krups/KREPE3-Hardware/README.md

# KREPE3-Hardware
PCB design files and documentation for the hardware used in the University of Kentucky's 2026 KRUPS ISS mission. Further information for each component is found in its respective folder.

### Hardware Folders
- [Low Power Data Logger](LPDataLogger)
