krups/KREPE3-Hardware/LPDataLogger/Documentation/LPDataLogger.step

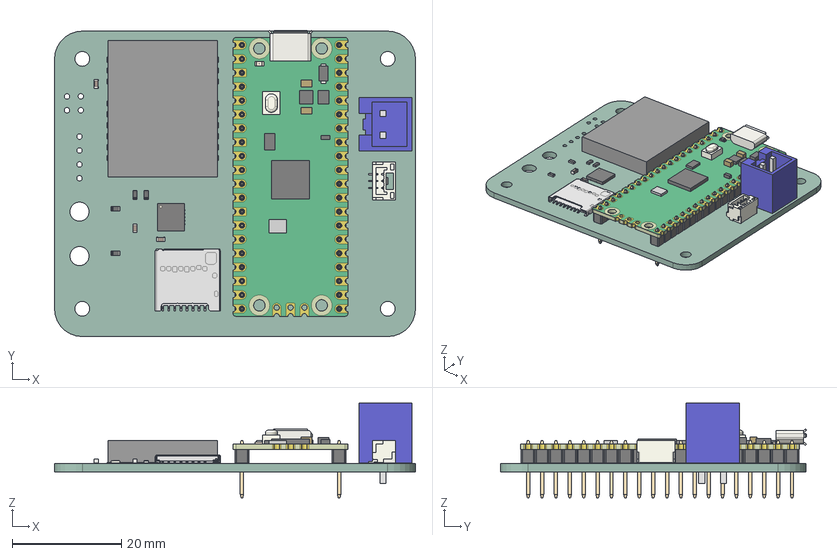
[picture p3: CAD file, 2025-04-11]
LPDataLogger/Documentation/LPDataLogger.step
66.0 x 56.0 x 17.4 mm
B2P-VH-FB-B
Pins
C_0603_1608Metric x 3
R_0603_1608Metric x 4
RaspberryPi_Pico_AddedHeaders
JST_GH_BM03B-GHS-TBT_1x03-1MP_P1.25mm_Vertical
QFN-20-1EP_5x5mm_P0.65mm_EP3.35x3.35mm
LPDataLogger_PCB
