krups/KREPE3-Hardware/LPDataLogger/KiCadProjectFiles/STEP/FSM300.stp

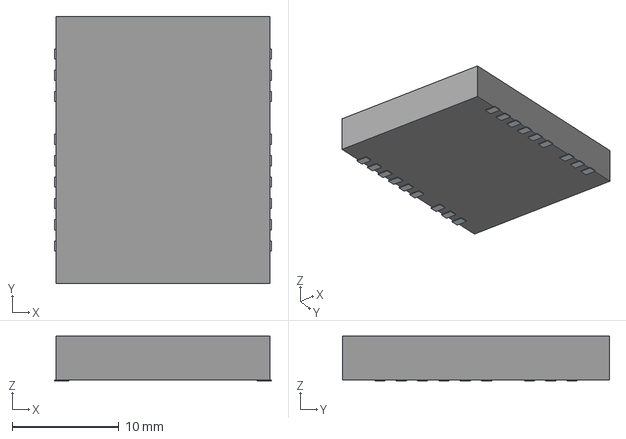
[picture p4: CAD file, 2025-04-10]
LPDataLogger/KiCadProjectFiles/STEP/FSM300.stp
20.4 x 25.0 x 4.20 mm
Pins
