krups/KREPE3-Hardware/LPDataLogger/KiCadProjectFiles/STEP/B2P-VH-FB-B.STEP

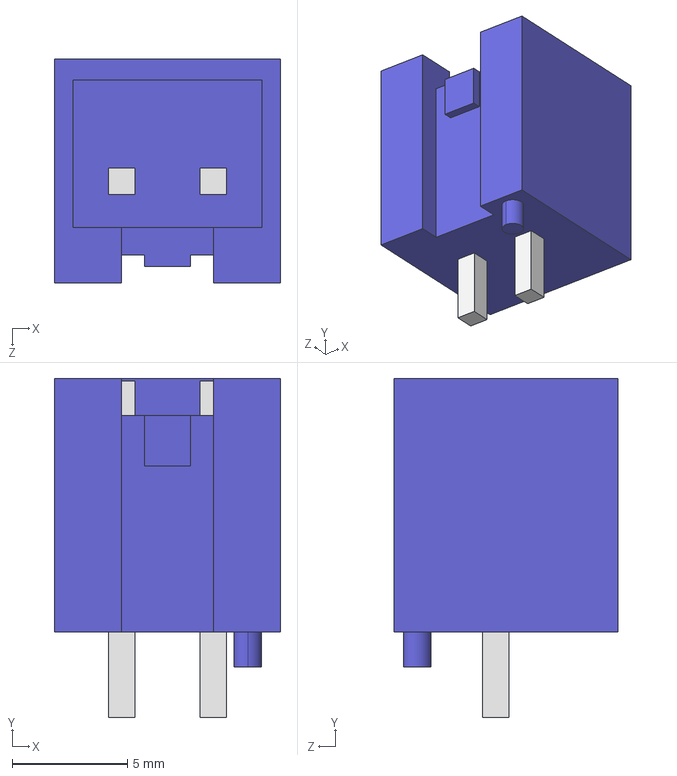
[picture p5: CAD file, 2025-04-10]
LPDataLogger/KiCadProjectFiles/STEP/B2P-VH-FB-B.STEP
9.80 x 14.7 x 9.70 mm
