krups/KREPE3-Hardware/LPDataLogger/KiCadProjectFiles/STEP/RaspberryPi_Pico_AddedHeaders.step

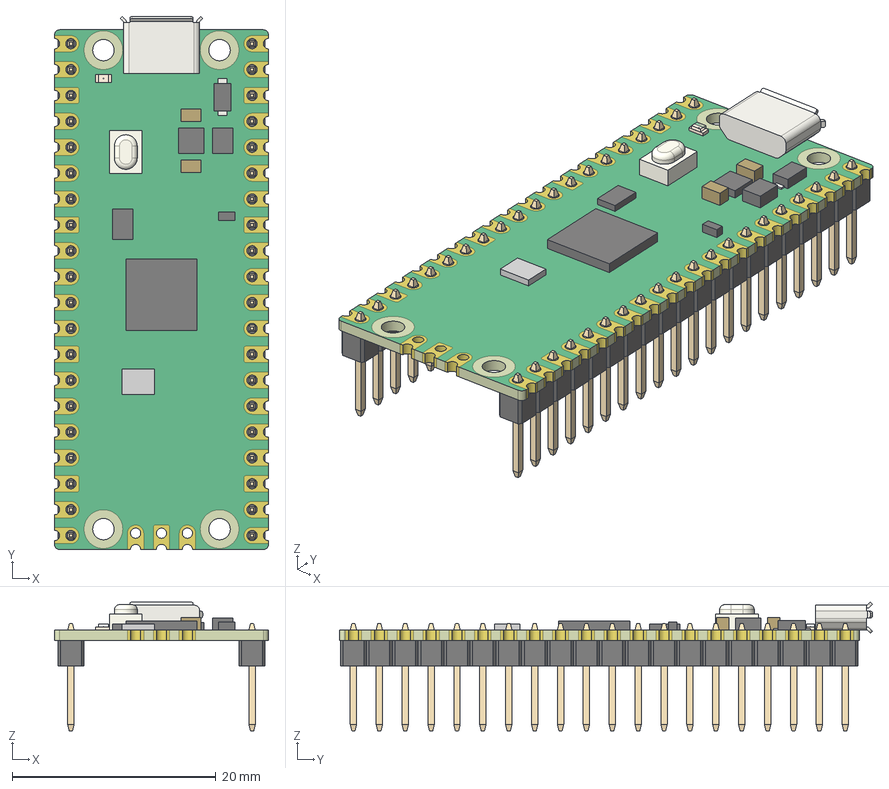
[picture p6: CAD file, 2025-04-10]
LPDataLogger/KiCadProjectFiles/STEP/RaspberryPi_Pico_AddedHeaders.step
21.0 x 52.3 x 12.6 mm
