krups/KREPE3-Hardware/LPDataLogger/KiCadProjectFiles/STEP/1040310811.stp

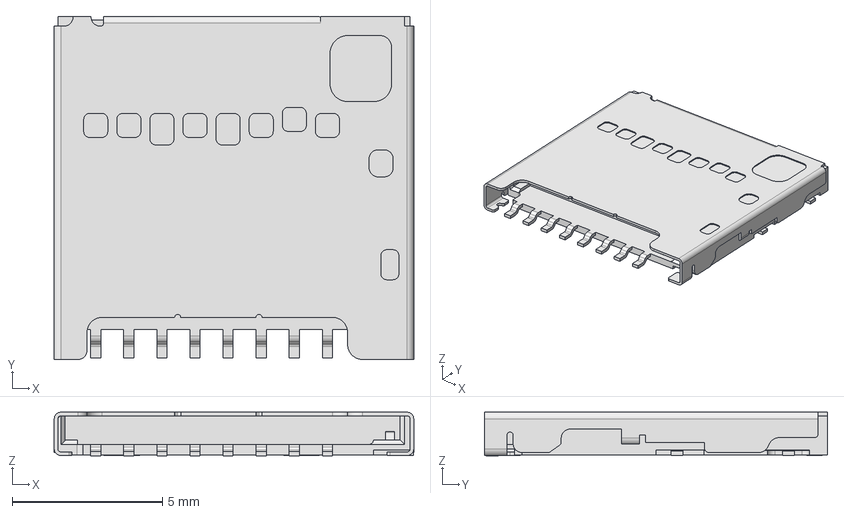
[picture p7: CAD file, 2025-04-10]
LPDataLogger/KiCadProjectFiles/STEP/1040310811.stp
11.9 x 11.4 x 1.45 mm
