krups/KREPE3-Hardware/LPDataLogger/Documentation/LPDataLogger.pdf

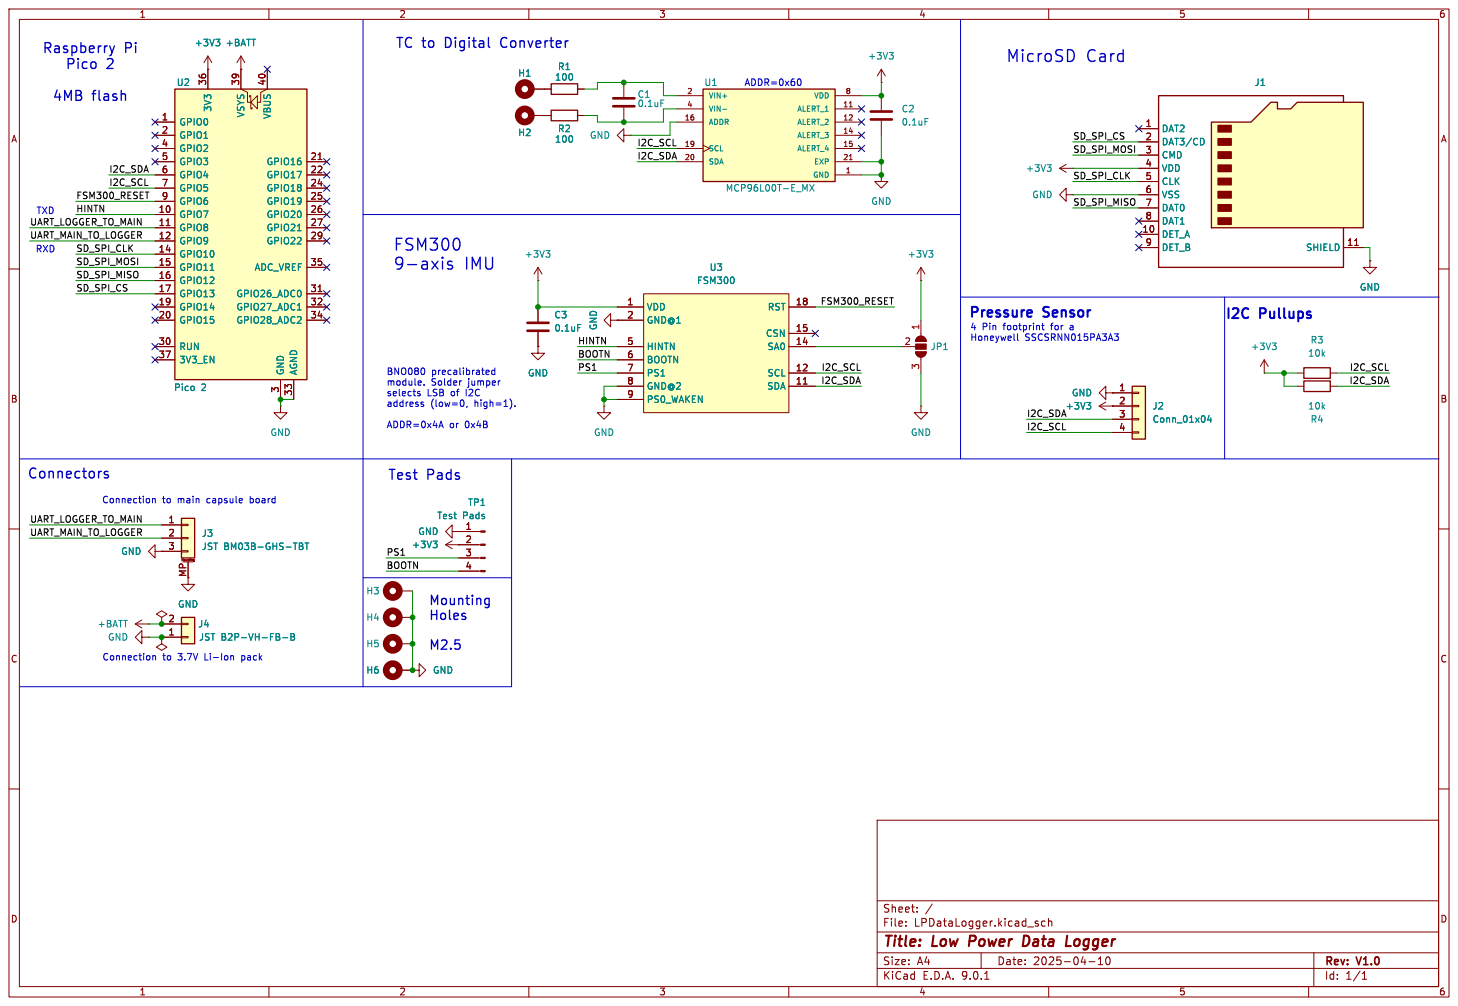
[picture p8: page 1]

TC to Digital Converter

BNO080 precalibrated module. Solder jumper selects LSB of I2C

Id: 1/1 Title: Low Power Data Logger File: LPDataLogger.kicad_sch Sheet: /
