krups/KREPE3-Hardware/LPDataLogger/KiCadProjectFiles/LPDataLogger.kicad_pcb

## KiCad design LPDataLogger/KiCadProjectFiles/LPDataLogger.kicad_pcb (2025-04-11)

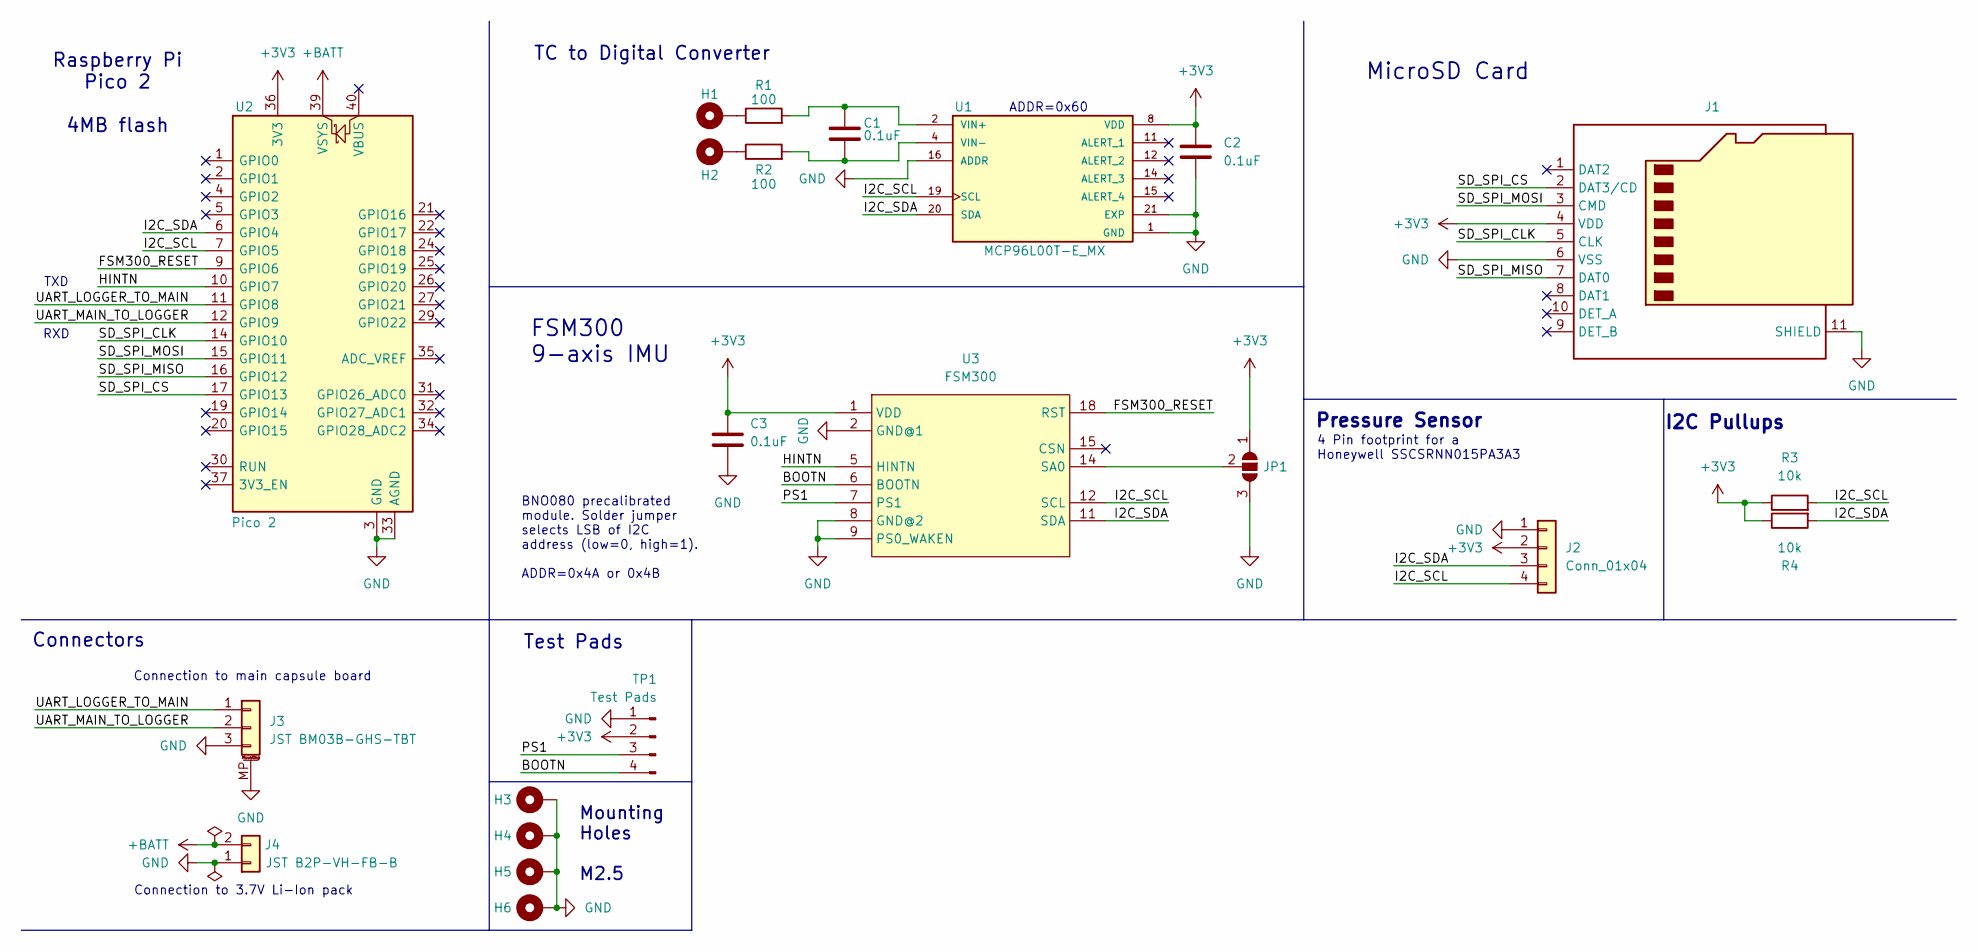
[picture p9: schematic LPDataLogger.kicad_sch, Low Power Data Logger]

Parts:
C1, C2, C3: 0.1uF; C_0603_1608Metric_Pad1.08x0.95mm_HandSolder; Digikey Part Number 0603B104K500XD
H1, H2: MountingHole_Pad; MountingHole_3.5mm_Pad
H3, H4, H5, H6: MountingHole_Pad; MountingHole_2.7mm_M2.5_Pad_with_stencil_hole
J1: Micro_SD_Card_Det2; microSD_HC_Molex_104031-0811; Digikey Part Number WM6357TR-ND
J2: Conn_01x04; PinHeader_1x04_P2.54mm_Vertical
J3: JST BM03B-GHS-TBT; JST_GH_BM03B-GHS-TBT_1x03-1MP_P1.25mm_Vertical; Digikey Part Number 455-BM03B-GHS-TBTCT-ND
J4: JST B2P-VH-FB-B; JST_VH_B2P-VH-FB-B_1x02_P3.96mm_Vertical; Digikey Part Number 455-B2P-VH-FB-B-ND
JP1: SolderJumper_3_Open; SolderJumper-3_P1.3mm_Open_RoundedPad1.0x1.5mm_NumberLabels
R1, R2: 100; R_0603_1608Metric_Pad0.98x0.95mm_HandSolder; Digikey Part Number 311-100GRTR-ND
R3, R4: 10k; R_0603_1608Metric_Pad0.98x0.95mm_HandSolder; Digikey Part Number 13-RC0603FR-1310KLTR-ND
TP1: Test Pads; PinHeader_2x02_P2.54mm_Vertical
U1: MCP96L00T-E_MX; QFN-20-1EP_5x5mm_P0.65mm_EP3.35x3.35mm; Digikey Part Number MCP96L00T-E/MXTR-ND
U2: Pico 2; RaspberryPi_Pico_Common_Unspecified; Digikey Part Number 2648-SC1631CT-ND
U3: FSM300; Digikey Part Number 1888-1001-ND

Connections:
+3V3: C2.1, C3.1, J1.4 (VDD), J2.2, JP1.1 (A), R3.1, R4.1, TP1.2, U1.8 (VDD), U2.36 (3V3), U3.1 (VDD)
+BATT: J4.2, U2.39 (VSYS)
/BOOTN: TP1.4, U3.6 (BOOTN)
/FSM300_RESET: U2.9 (GPIO6), U3.18 (RST)
/HINTN: U2.10 (GPIO7), U3.5 (HINTN)
/I2C_SCL: J2.4, R3.2, U1.19 (SCL), U2.7 (GPIO5), U3.12 (SCL)
/I2C_SDA: J2.3, R4.2, U1.20 (SDA), U2.6 (GPIO4), U3.11 (SDA)
/PS1: TP1.3, U3.7 (PS1)
/SD_SPI_CLK: J1.5 (CLK), U2.14 (GPIO10)
/SD_SPI_CS: J1.2 (DAT3/CD), U2.17 (GPIO13)
/SD_SPI_MISO: J1.7 (DAT0), U2.16 (GPIO12)
/SD_SPI_MOSI: J1.3 (CMD), U2.15 (GPIO11)
/UART_LOGGER_TO_MAIN: J3.1, U2.11 (GPIO8)
/UART_MAIN_TO_LOGGER: J3.2, U2.12 (GPIO9)
GND: C2.2, C3.2, H3.1, H4.1, H5.1, H6.1, J1.6 (VSS), J1.11 (SHIELD), J2.1, J3.3, J3.MP (MountPin), J4.1, JP1.3 (B), TP1.1, U1.1 (GND), U1.3 (GND__1), U1.5 (GND__2), U1.6 (GND__3), U1.7 (GND__4), U1.9 (GND__5), U1.10 (GND__6), U1.13 (GND__7), U1.16 (ADDR), U1.17 (GND__8), U1.18 (GND__9), U1.21 (EXP), U2.3 (GND), U2.8 (GND), U2.13 (GND), U2.18 (GND), U2.23 (GND), U2.28 (GND), U2.33 (AGND), U2.38 (GND), U3.2 (GND@1), U3.8 (GND@2), U3.9 (PS0_WAKEN)
unnamed: H1.1, R1.1
unnamed: H2.1, R2.1
unnamed: JP1.2 (C), U3.14 (SA0)
unnamed: C1.1, R1.2, U1.2 (VIN+)
unnamed: C1.2, R2.2, U1.4 (VIN-)

Notes on the sheet:
Connection to main capsule board
MicroSD Card
Mounting Holes M2.5
Connection to 3.7V Li-Ion pack
Test Pads
TC to Digital Converter
I2C Pullups
RXD
FSM300 9-axis IMU
TXD
Pressure Sensor
Connectors
ADDR=0x60
4 Pin footprint for a Honeywell SSCSRNN015PA3A3
BNO080 precalibrated module. Solder jumper selects LSB of I2C address (low=0, high=1). ADDR=0x4A or 0x4B
Raspberry Pi Pico 2 4MB flash

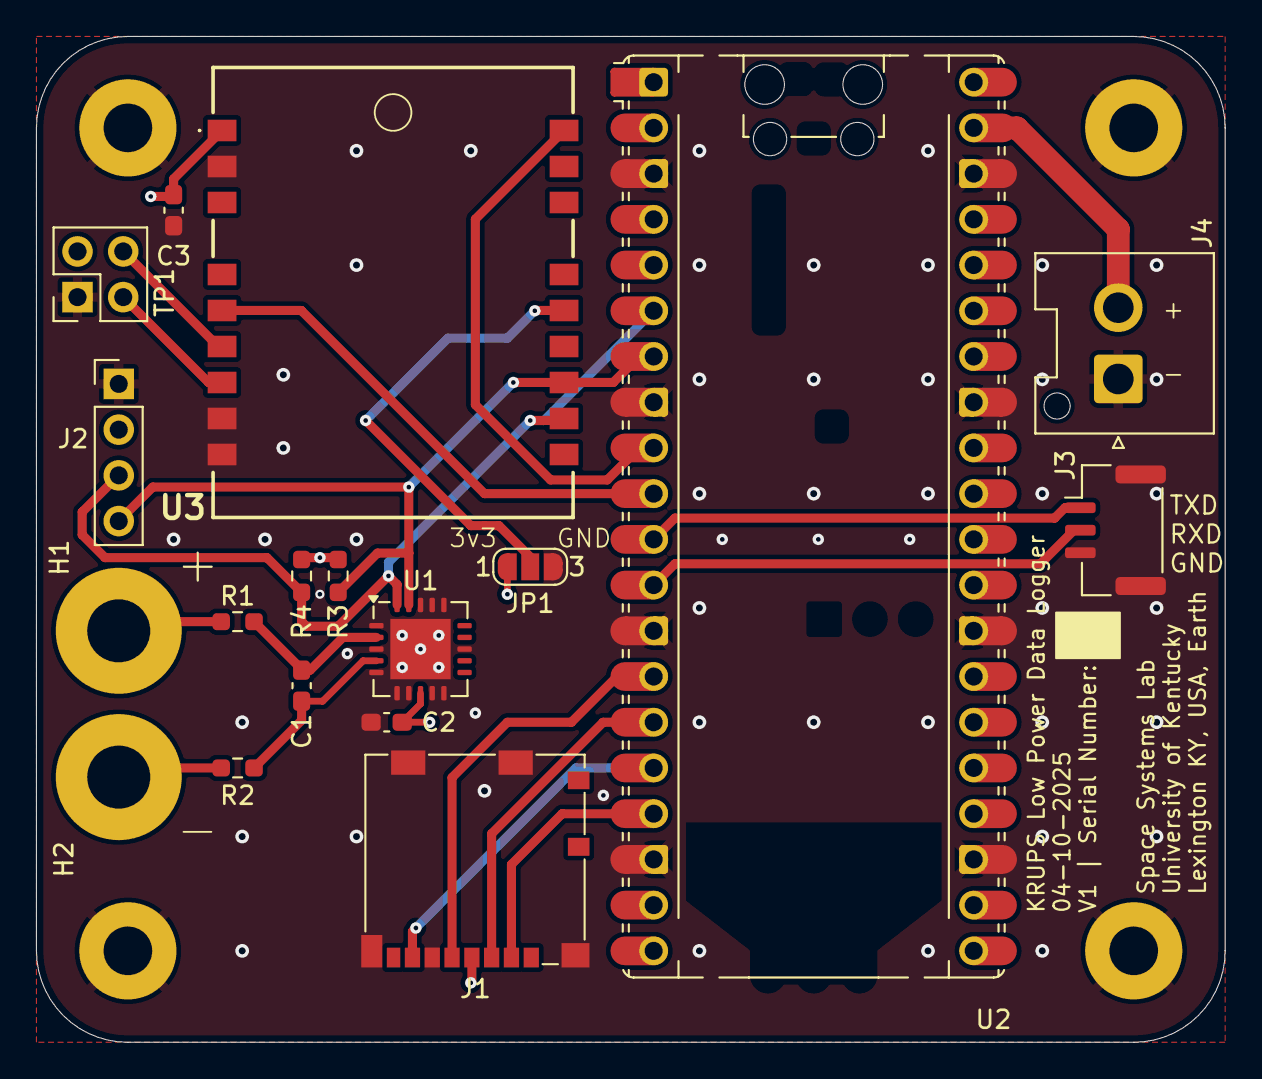
[picture p10: board LPDataLogger.kicad_pcb from above]

Board: 4 copper layers, 66.0 x 55.9 mm, 22 parts (0 on the bottom side), 20 nets.
