krups/KREPE3-Hardware/(commit log)

2025-04-10 finished first draft of low power data logger schematic
    [1040310811.stp, B2P-VH-FB-B.STEP, FSM300.stp, LPDataLogger.kicad_pcb, LPDataLogger.kicad_sch, RaspberryPi_Pico_AddedHeaders.step]
2025-04-11 Finished V1 of the low power data logger
    [LPDataLogger.kicad_pcb, LPDataLogger.kicad_sch, LPDataLogger.step, LPDataLogger_BOM.csv]
2025-04-11 added silkscreen, schematic labels for UART pins
    [LPDataLogger.kicad_pcb, LPDataLogger.kicad_sch, LPDataLogger.step]
2025-04-11 fixed LPDL BOM
    [LPDataLogger.kicad_sch, LPDataLogger.step, LPDataLogger_BOM.csv]
